sora-kitano/sora_kitano/macbook-cart-cable/stl/d3.4/stopper_rear_noliner_half_d3.4.stl

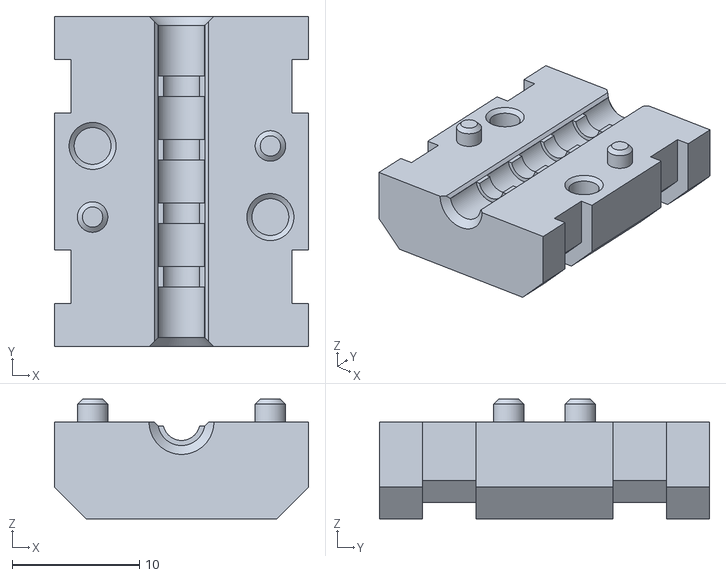
[picture p7: CAD file, 2026-10-14]
macbook-cart-cable/stl/d3.4/stopper_rear_noliner_half_d3.4.stl
20.0 x 26.0 x 9.43
