sora-kitano/sora_kitano/macbook-cart-cable/stl/d3.6/slack_holder_d3.6.stl

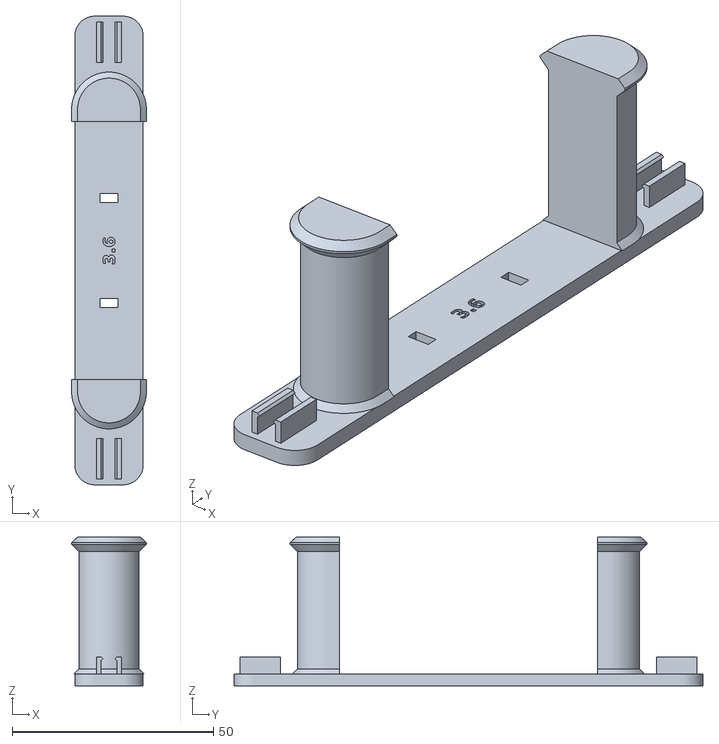
[picture p8: CAD file, 2026-10-14]
macbook-cart-cable/stl/d3.6/slack_holder_d3.6.stl
18.6 x 116.4 x 37.0
