sora-kitano/sora_kitano/macbook-cart-cable/stl/d4.0/stopper_rear_half_d4.0.stl

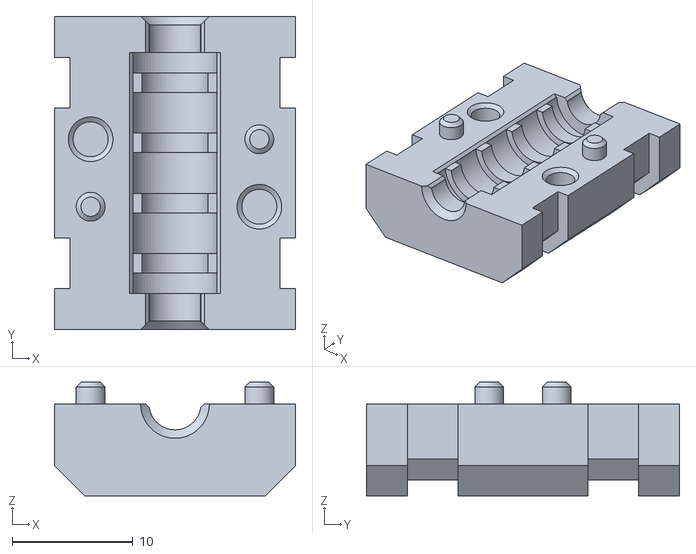
[picture p9: CAD file, 2026-10-14]
macbook-cart-cable/stl/d4.0/stopper_rear_half_d4.0.stl
20.0 x 26.0 x 9.43
