sora-kitano/sora_kitano/macbook-cart-cable/stl/d4.8/stopper_front_half_d4.8.stl

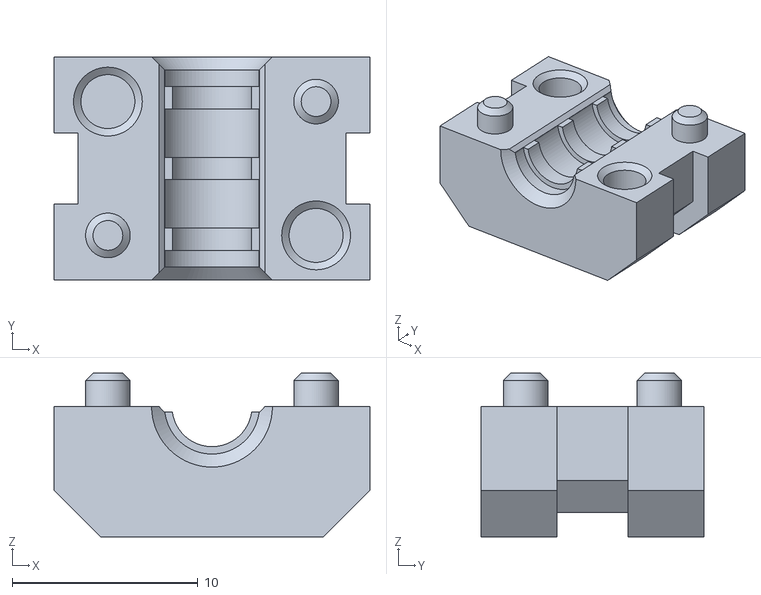
[picture p10: CAD file, 2026-10-14]
macbook-cart-cable/stl/d4.8/stopper_front_half_d4.8.stl
17.0 x 12.0 x 8.80
