sora-kitano/sora_kitano/macbook-cart-cable/stl/tube_cut_guide_3x5.stl

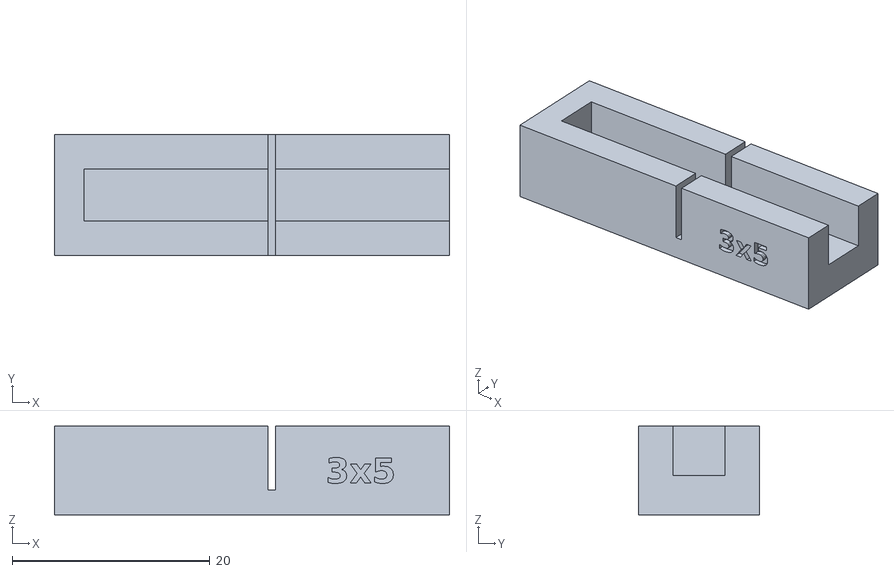
[picture p11: CAD file, 2026-10-14]
macbook-cart-cable/stl/tube_cut_guide_3x5.stl
40.0 x 12.3 x 9.00
