sora-kitano/sora_kitano/macbook-cart-cable/stl/d4.6/slack_holder_d4.6.stl

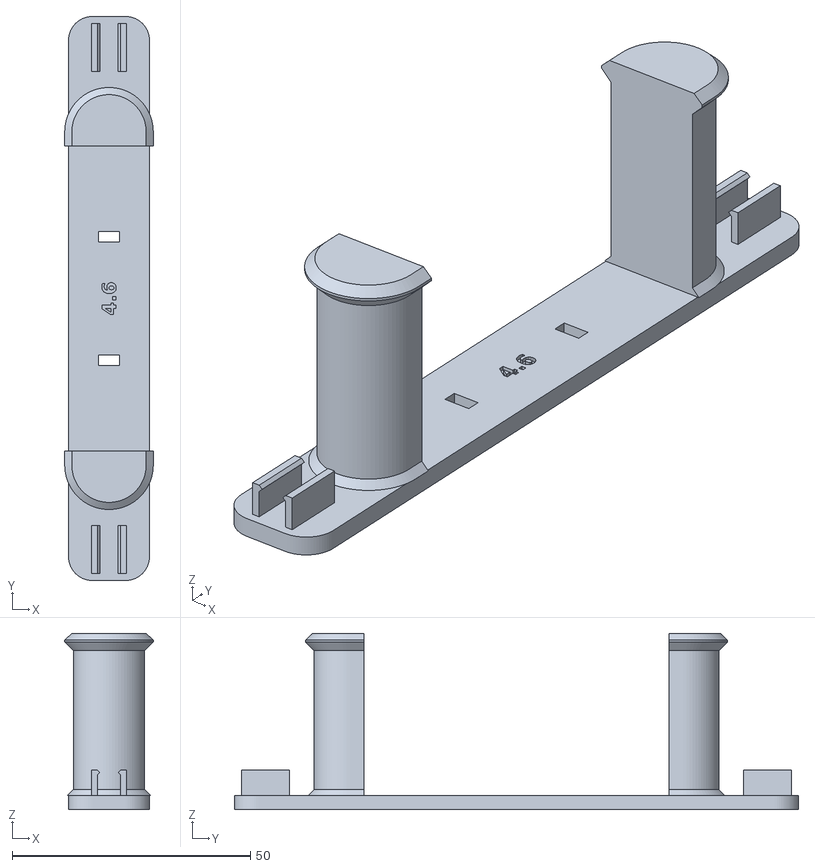
[picture p12: CAD file, 2026-10-14]
macbook-cart-cable/stl/d4.6/slack_holder_d4.6.stl
18.6 x 118.4 x 37.0
