sora-kitano/sora_kitano/macbook-cart-cable/stl/d5.4/slack_holder_d5.4.stl

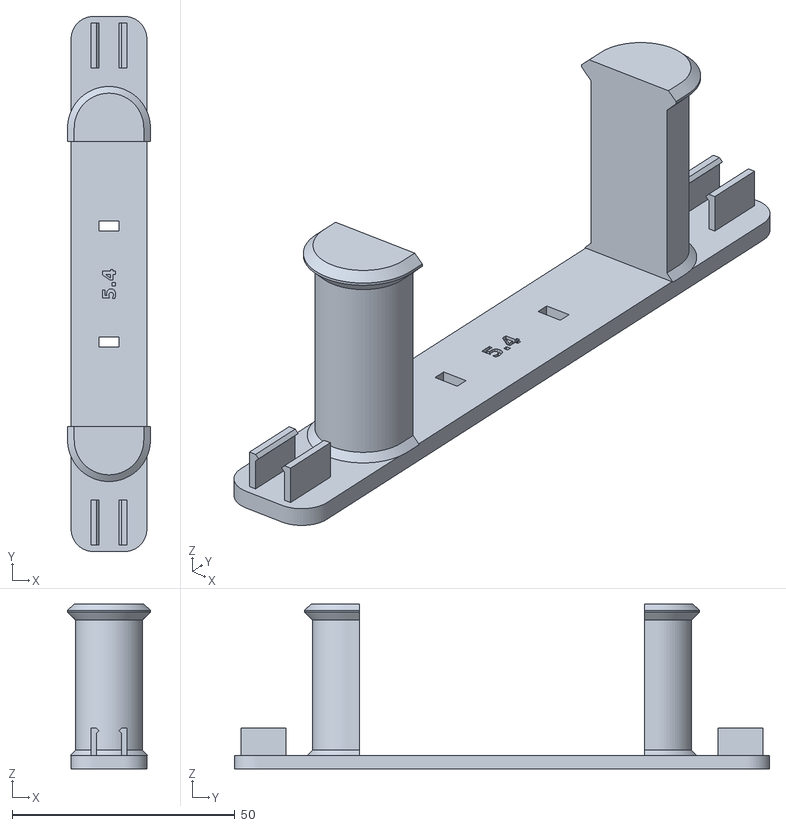
[picture p13: CAD file, 2026-10-14]
macbook-cart-cable/stl/d5.4/slack_holder_d5.4.stl
18.6 x 120.0 x 37.0
