sora-kitano/sora_kitano/macbook-cart-cable/stl/tube_cut_guide_4x6.stl

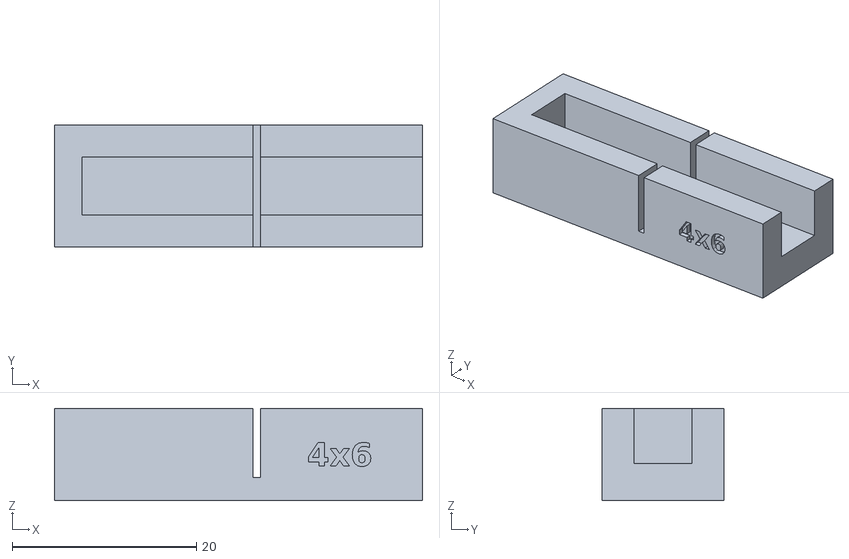
[picture p14: CAD file, 2026-10-14]
macbook-cart-cable/stl/tube_cut_guide_4x6.stl
40.0 x 13.3 x 10.0
