sora-kitano/sora_kitano/macbook-cart-cable/stl/d4.2/slack_holder_d4.2.stl

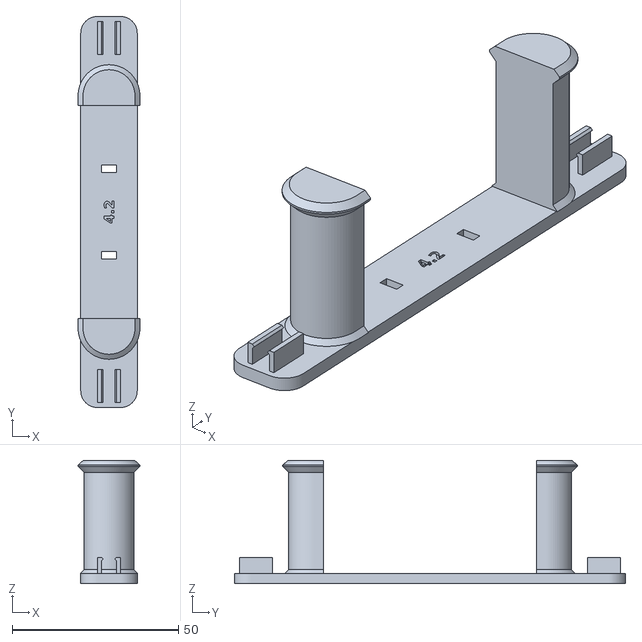
[picture p15: CAD file, 2026-10-14]
macbook-cart-cable/stl/d4.2/slack_holder_d4.2.stl
18.6 x 117.6 x 37.0
