sora-kitano/sora_kitano/macbook-cart-cable/stl/slip_test_jig.stl

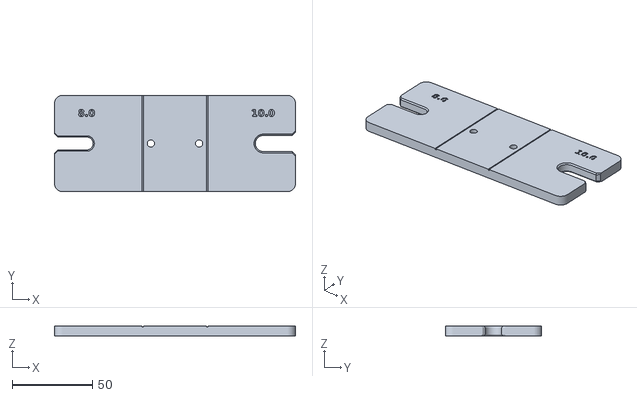
[picture p16: CAD file, 2026-10-14]
macbook-cart-cable/stl/slip_test_jig.stl
150.0 x 60.0 x 6.00
