sora-kitano/sora_kitano/macbook-cart-cable/stl/tube_cut_guide_5x7.stl

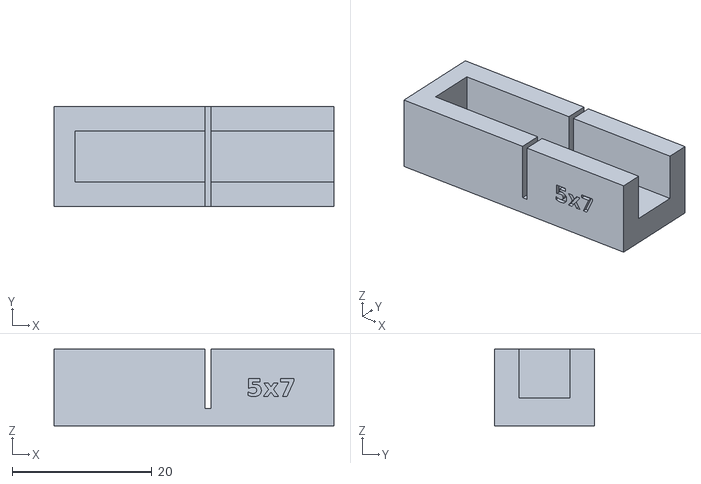
[picture p17: CAD file, 2026-10-14]
macbook-cart-cable/stl/tube_cut_guide_5x7.stl
40.0 x 14.3 x 11.0
