sora-kitano/sora_kitano/macbook-cart-cable/stl/cable_gauge.stl

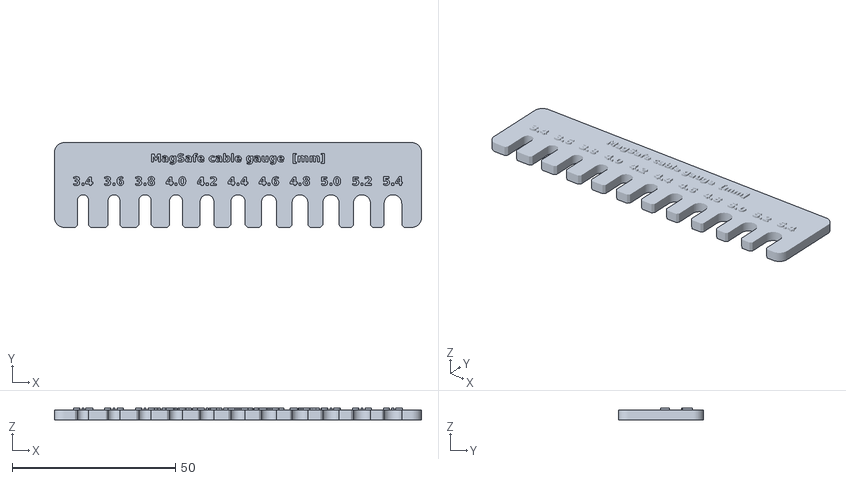
[picture p18: CAD file, 2026-10-14]
macbook-cart-cable/stl/cable_gauge.stl
112.5 x 26.0 x 3.60
