sora-kitano/sora_kitano/(list of files, cad)

Other CAD files:
macbook-cart-cable/stl/d3.8/slack_holder_d3.8.stl
macbook-cart-cable/stl/d4.2/stopper_rear_noliner_half_d4.2.stl
macbook-cart-cable/stl/d4.4/stopper_rear_noliner_half_d4.4.stl
macbook-cart-cable/stl/d4.6/stopper_rear_noliner_half_d4.6.stl
macbook-cart-cable/stl/d5.0/stopper_rear_noliner_half_d5.0.stl
macbook-cart-cable/stl/d5.2/stopper_front_half_d5.2.stl
macbook-cart-cable/stl/d5.4/stopper_rear_half_d5.4.stl
macbook-cart-cable/stl/d3.4/stopper_front_half_d3.4.stl
macbook-cart-cable/stl/d3.6/stopper_front_half_d3.6.stl
macbook-cart-cable/stl/d3.8/stopper_rear_half_d3.8.stl
macbook-cart-cable/stl/d4.0/stopper_rear_noliner_half_d4.0.stl
macbook-cart-cable/stl/d4.2/stopper_front_half_d4.2.stl
macbook-cart-cable/stl/d4.4/stopper_rear_half_d4.4.stl
macbook-cart-cable/stl/d4.8/stopper_rear_half_d4.8.stl
macbook-cart-cable/stl/d5.0/stopper_front_half_d5.0.stl
macbook-cart-cable/stl/d5.2/stopper_rear_half_d5.2.stl
macbook-cart-cable/stl/d3.4/slack_holder_d3.4.stl
macbook-cart-cable/stl/d3.6/stopper_rear_noliner_half_d3.6.stl
macbook-cart-cable/stl/d3.8/stopper_front_half_d3.8.stl
macbook-cart-cable/stl/d4.0/stopper_front_half_d4.0.stl
macbook-cart-cable/stl/d4.4/slack_holder_d4.4.stl
macbook-cart-cable/stl/d4.6/stopper_rear_half_d4.6.stl
macbook-cart-cable/stl/d4.8/slack_holder_d4.8.stl
macbook-cart-cable/stl/d5.0/slack_holder_d5.0.stl
macbook-cart-cable/stl/d5.2/slack_holder_d5.2.stl
macbook-cart-cable/stl/d5.4/stopper_rear_noliner_half_d5.4.stl
macbook-cart-cable/stl/d3.4/stopper_rear_half_d3.4.stl
macbook-cart-cable/stl/d3.6/stopper_rear_half_d3.6.stl
macbook-cart-cable/stl/d3.8/stopper_rear_noliner_half_d3.8.stl
macbook-cart-cable/stl/d4.0/slack_holder_d4.0.stl
macbook-cart-cable/stl/d4.2/stopper_rear_half_d4.2.stl
macbook-cart-cable/stl/d4.4/stopper_front_half_d4.4.stl
macbook-cart-cable/stl/d4.6/stopper_front_half_d4.6.stl
macbook-cart-cable/stl/d4.8/stopper_rear_noliner_half_d4.8.stl
macbook-cart-cable/stl/d5.0/stopper_rear_half_d5.0.stl
macbook-cart-cable/stl/d5.2/stopper_rear_noliner_half_d5.2.stl
macbook-cart-cable/stl/d5.4/stopper_front_half_d5.4.stl
