sora-kitano/sora_kitano/(commit log)

2026-10-14 Add 3D-printable cable management parts for MacBook charging cart
    - cable_gauge: side-loading slot gauge (3.4-5.4 mm) to measure the MagSafe cable
    - stopper_half: zip-tied split collar; a pair on each side of the existing
    front clip locks the cable front/back so the hanging length stays fixed
    - slack_holder: two-hook holder that stores the excess cable at the back
    without twisting it
    - STLs for each cable size, parametric generator (manifold3d), previews and
    a Japanese install guide
    Claude-Session: https://claude.ai/code/session_01Jh6kzn6fHNuHr3WMg2a5p7
    [cable_gauge.stl, slack_holder_d3.4.stl, slack_holder_d3.6.stl, slack_holder_d3.8.stl, slack_holder_d4.0.stl, slack_holder_d4.2.stl, slack_holder_d4.4.stl, slack_holder_d4.6.stl]
2026-10-14 Redesign rear cable stopper with silicone liner and add slip-test jig
    - stopper_rear_half: 26 mm two-tie clamp; ribs squeeze a slit 1 mm silicone
    tube by 0.25 mm when the seam closes, so clamp force is set by geometry
    - stopper_front_half: small front-side stopper (old part, chamfered edges)
    - stopper_rear_noliner_half: fallback without tube
    - slip_test_jig and tube_cut_guide for a 30 N bench pull test
    - README rewritten with load target, test procedure and pass criteria
    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
    [slip_test_jig.stl, stopper_front_half_d3.4.stl, stopper_front_half_d3.6.stl, stopper_front_half_d3.8.stl, stopper_front_half_d4.0.stl, stopper_front_half_d4.2.stl, stopper_front_half_d4.4.stl, stopper_front_half_d4.6.stl]
2026-10-14 Apply review fixes to stoppers, test procedure and docs; add STL zip
    - rear stopper: H 7.625 so the seam lands on a 0.2 mm layer, relief 0.5 mm
    (gland fill <= ~82% even at S-0.2), seam chamfers kept off the pocket end
    so every STL is watertight (checked on export)
    - front stopper pin moved for a thicker wall; holder anchor gap >= d+0.6 so
    the bottom loop fits; jig cable 35 mm out from the desk; tube guide cuts
    18.6-19.0 mm
    - README: slip measured with a pen mark and calipers from a 10 s zero,
    bottle laid horizontal with taped wrap, test D sizes, 40 N cap, step 7
    no longer suggests untested sizes, corrected capacities and weights
    - macbook-cart-cable-stl.zip with all STLs, README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
    [slack_holder_d3.4.stl, slack_holder_d3.6.stl, slack_holder_d3.8.stl, slack_holder_d4.0.stl, slack_holder_d4.2.stl, slack_holder_d4.4.stl, slack_holder_d4.6.stl, slack_holder_d4.8.stl]
2026-10-19 Add wordless manga sheet for interview answers (mki_manga.html)
    Ten answers drawn as inline-SVG panel strips with a one-line opening
    sentence under each. Single self-contained file; responsive down to
    375px and print-friendly.
    Claude-Session: https://claude.ai/code/session_01JHumhpdYGaftXBQ3HAiXS4
